NSCC/CoNtrOleR/README.md

# CoNtrOleR
The wiki contains our Scrum minutes

**our goal is to create a wooden chassis, usb  controller with the highest build quility we can manage**
