NSCC/CoNtrOleR/analog stick datasheet.png

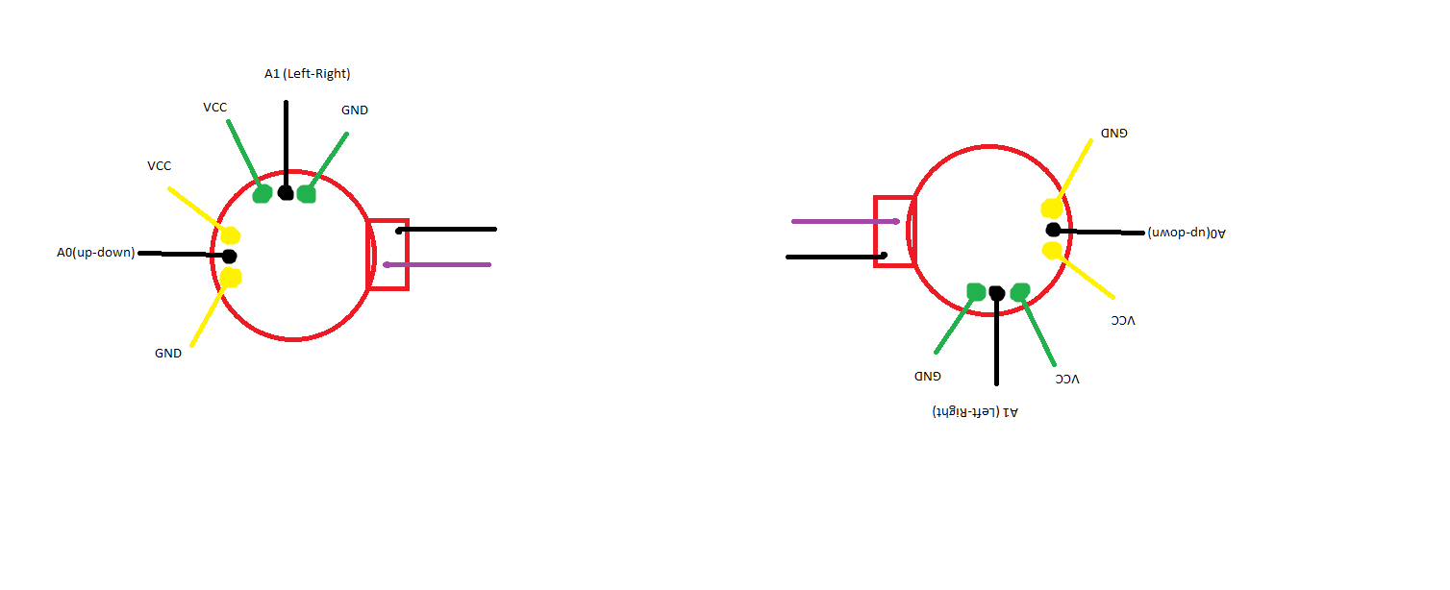
analog stick datasheet.png
