NSCC/CoNtrOleR/Project Management/PC-JP-NS-ProjectPlanning-Assignment3-Part2.xlsx

Sheet: Task_Table
ID | Active | Task Mode | Name | Duration | Start | Finish | Predecessors | Outline Level | Notes
1 | Yes | Manually Scheduled | Arduino I/O sketch | 0 hrs | March 4, 2019 8:00 AM | March 4, 2019 8:00 AM |  | 1
2 | Yes | Manually Scheduled | Bread-board prototype | 0 hrs | March 4, 2019 5:00 PM | March 4, 2019 5:00 PM |  | 1
3 | Yes | Manually Scheduled | Clay Model Chassis | 0 hrs | March 18, 2019 11:53 AM | March 18, 2019 11:53 AM |  | 1
4 | Yes | Manually Scheduled | Manufacturing Ready PCB | 0 hrs | March 25, 2019 5:00 PM | March 25, 2019 5:00 PM |  | 1
5 | Yes | Manually Scheduled | Complete 3D Chassis Model | 0 hrs | March 25, 2019 8:00 AM | March 25, 2019 8:00 AM |  | 1
6 | Yes | Manually Scheduled |  |  |  |  |  | 1
7 | Yes | Manually Scheduled | Calculated person hours: 272.2 |  |  |  |  | 1
8 | Yes | Manually Scheduled |  |  |  |  |  | 1
9 | Yes | Auto Scheduled | Program Physical Button Presses to Be Keyboard/Controller Output | 2 hrs | February 25, 2019 8:31 AM | February 25, 2019 10:31 AM |  | 1
10 | Yes | Auto Scheduled | Research Teensy Arduino API for button input/output | 1 hr | February 25, 2019 8:31 AM | February 25, 2019 9:31 AM |  | 2
11 | Yes | Auto Scheduled | Program Button Pinouts | 1 hr | February 25, 2019 9:31 AM | February 25, 2019 10:31 AM | 10 | 2
12 |  |  |  |  |  |  |  | 2
13 | Yes | Auto Scheduled | Program Physical Analog Stick Movement to Digital Analog Output | 2 hrs | February 25, 2019 10:35 AM | February 25, 2019 1:35 PM |  | 1
14 | Yes | Auto Scheduled | Research Analog Input and Output | 1 hr | February 25, 2019 10:35 AM | February 25, 2019 11:35 AM |  | 2
15 | Yes | Auto Scheduled | Program Analog Stick Pinouts | 1 hr | February 25, 2019 11:35 AM | February 25, 2019 1:35 PM | 14 | 2
16 |  |  |  |  |  |  |  | 2
17 | Yes | Auto Scheduled | Program A "Serial Mode" To Take Button Inputs As Serial Data | 6 hrs | February 26, 2019 9:11 AM | February 26, 2019 4:11 PM |  | 1
18 | Yes | Auto Scheduled | Research how to transmit data serially through a Teensy Arduino | 5 hrs | February 26, 2019 9:11 AM | February 26, 2019 3:11 PM |  | 2
19 | Yes | Auto Scheduled | Program Buttons To Transmit Only Serial Data For Software | 1 hr | February 26, 2019 3:11 PM | February 26, 2019 4:11 PM | 18 | 2
20 |  |  |  |  |  |  |  | 2
21 | Yes | Auto Scheduled | Program Software To Detect Arduino COM Port | 3 hrs | February 27, 2019 9:18 AM | February 27, 2019 1:18 PM |  | 1
22 | Yes | Auto Scheduled | Find A C99 Library That Can Detect COM Ports | 2 hrs | February 27, 2019 9:18 AM | February 27, 2019 11:18 AM |  | 2
23 | Yes | Auto Scheduled | Program COM Port Detection | 1 hr | February 27, 2019 11:18 AM | February 27, 2019 1:18 PM | 22 | 2
24 |  |  |  |  |  |  |  | 2
25 | Yes | Auto Scheduled | Read Serial Inputs And Give Variable Keyboard/Contoller Output | 8 hrs | February 27, 2019 1:18 PM | February 28, 2019 1:18 PM | 21 | 1
26 | Yes | Auto Scheduled | Take The Data From The COM Port And Parse It Into Manageable Data | 3 hrs | February 27, 2019 1:18 PM | February 27, 2019 4:18 PM |  | 2
27 | Yes | Auto Scheduled | Emulate Button Presses Based On Software Variables | 5 hrs | February 27, 2019 4:18 PM | February 28, 2019 1:18 PM | 26 | 2
28 |  |  |  |  |  |  |  | 2
29 | Yes | Auto Scheduled | GUI | 66.15 hrs | February 28, 2019 1:26 PM | March 12, 2019 3:35 PM |  | 1
30 | Yes | Auto Scheduled | Windows GUI | 29 hrs | February 28, 2019 1:26 PM | March 6, 2019 9:26 AM |  | 2
31 | Yes | Auto Scheduled | Program A Graphical Button-Mapping Software | 5 hrs | February 28, 2019 1:26 PM | March 1, 2019 9:26 AM |  | 3
32 | Yes | Auto Scheduled | Add Graphics | 8 hrs | March 1, 2019 9:26 AM | March 4, 2019 9:26 AM | 31 | 3
33 | Yes | Auto Scheduled | Add On-Click-Listeners | 8 hrs | March 4, 2019 9:26 AM | March 5, 2019 9:26 AM | 32 | 3
34 | Yes | Auto Scheduled | Program user controlled variables for button-mapping | 8 hrs | March 5, 2019 9:26 AM | March 6, 2019 9:26 AM | 33 | 3
35 | Yes | Auto Scheduled | LINUX GUI | 37 hrs | March 6, 2019 9:35 AM | March 12, 2019 3:35 PM |  | 2
36 | Yes | Auto Scheduled | Program a graphical button-mapping software | 13 hrs | March 6, 2019 9:35 AM | March 7, 2019 3:35 PM |  | 3
37 | Yes | Auto Scheduled | Add graphics | 8 hrs | March 7, 2019 3:35 PM | March 8, 2019 3:35 PM | 36 | 3
38 | Yes | Auto Scheduled | Add on-click listeners | 8 hrs | March 8, 2019 3:35 PM | March 11, 2019 3:35 PM | 37 | 3
39 | Yes | Auto Scheduled | Program user controlled variables for button-mapping | 8 hrs | March 11, 2019 3:35 PM | March 12, 2019 3:35 PM | 38 | 3
40 |  |  |  |  |  |  |  | 3
41 | Yes | Auto Scheduled | Bread-Board Circuit Design | 2 hrs | February 25, 2019 9:00 AM | February 25, 2019 11:00 AM |  | 1
42 | Yes | Auto Scheduled | Rough sketch of circuit | 1 hr | February 25, 2019 9:00 AM | February 25, 2019 10:00 AM |  | 2
43 | Yes | Auto Scheduled | Wire test circuit | 0.5 hrs | February 25, 2019 10:00 AM | February 25, 2019 10:30 AM | 42 | 2
44 | Yes | Auto Scheduled | Test the circuit | 0.5 hrs | February 25, 2019 10:30 AM | February 25, 2019 11:00 AM | 43 | 2
45 |  |  |  |  |  |  |  | 2
46 | Yes | Auto Scheduled | Perf-Board Circuit Design | 2.5 hrs | February 25, 2019 11:00 AM | February 25, 2019 2:30 PM |  | 1
47 | Yes | Auto Scheduled | Clean up rough sketch | 0.5 hrs | February 25, 2019 11:00 AM | February 25, 2019 11:30 AM |  | 2
48 | Yes | Auto Scheduled | Solder components to perf board | 1 hr | February 25, 2019 11:30 AM | February 25, 2019 1:30 PM | 47 | 2
49 | Yes | Auto Scheduled | Test the Circuit | 1 hr | February 25, 2019 1:30 PM | February 25, 2019 2:30 PM | 48 | 2
50 |  |  |  |  |  |  |  | 2
51 | Yes | Auto Scheduled | PCB Schematic | 5.2 hrs | February 25, 2019 2:30 PM | February 26, 2019 10:42 AM | 49 | 1
52 | Yes | Auto Scheduled | Create library components | 3 hrs | February 25, 2019 2:30 PM | February 26, 2019 8:30 AM |  | 2
53 | Yes | Auto Scheduled | Place components in schematic | 0.2 hrs | February 26, 2019 8:30 AM | February 26, 2019 8:42 AM | 52 | 2
54 | Yes | Auto Scheduled | Add PCB footprints | 1 hr | February 26, 2019 8:42 AM | February 26, 2019 9:42 AM | 53 | 2
55 | Yes | Auto Scheduled | Physical and electrical rules check | 1 hr | February 26, 2019 9:42 AM | February 26, 2019 10:42 AM | 54 | 2
56 |  |  |  |  |  |  |  | 2
57 | Yes | Auto Scheduled | PCB Footprints | 7.5 hrs | February 26, 2019 9:56 AM | February 27, 2019 9:26 AM |  | 1
58 | Yes | Auto Scheduled | Create throughhole pads | 3 hrs | February 26, 2019 9:56 AM | February 26, 2019 1:56 PM |  | 2
59 | Yes | Auto Scheduled | Draw the silkscreen outlines | 1 hr | February 26, 2019 1:56 PM | February 26, 2019 2:56 PM | 58 | 2
60 | Yes | Auto Scheduled | Place the throughhole pads | 0.5 hrs | February 26, 2019 2:56 PM | February 26, 2019 3:26 PM | 59 | 2
61 | Yes | Auto Scheduled | Add the Silkscreen text | 1 hr | February 26, 2019 3:26 PM | February 26, 2019 4:26 PM | 60 | 2
62 | Yes | Auto Scheduled | Add reference designators | 1 hr | February 26, 2019 4:26 PM | February 27, 2019 8:26 AM | 61 | 2
63 | Yes | Auto Scheduled | Add the frectangle | 1 hr | February 27, 2019 8:26 AM | February 27, 2019 9:26 AM | 62 | 2
64 |  |  |  |  |  |  |  | 2
65 | Yes | Auto Scheduled | PCB Design (rough) | 3 hrs | February 27, 2019 9:34 AM | February 27, 2019 1:34 PM |  | 1
66 | Yes | Auto Scheduled | Place all the components from the schematic | 1 hr | February 27, 2019 9:34 AM | February 27, 2019 10:34 AM |  | 2
67 | Yes | Auto Scheduled | Arrange components around the estimated button positions | 1 hr | February 27, 2019 10:34 AM | February 27, 2019 11:34 AM | 66 | 2
68 | Yes | Auto Scheduled | Route traces | 1 hr | February 27, 2019 11:34 AM | February 27, 2019 1:34 PM | 67 | 2
69 |  |  |  |  |  |  |  | 2
70 | Yes | Auto Scheduled | PCB Design (finished) | 4 hrs | February 27, 2019 1:34 PM | February 28, 2019 8:34 AM | 65 | 1
71 | Yes | Auto Scheduled | Get the exact measurements from the 3d model | 1 hr | February 27, 2019 1:34 PM | February 27, 2019 2:34 PM |  | 2
72 | Yes | Auto Scheduled | Adjust components | 2 hrs | February 27, 2019 2:34 PM | February 27, 2019 4:34 PM | 71 | 2
73 | Yes | Auto Scheduled | Re-route traces | 1 hr | February 27, 2019 4:34 PM | February 28, 2019 8:34 AM | 72 | 2
74 | Yes | Auto Scheduled | Manufacturing | 22 hrs? | February 28, 2019 8:34 AM | March 4, 2019 3:34 PM | 70 | 1
75 | Yes | Auto Scheduled | Find a manufacturer | 8 hrs | February 28, 2019 8:34 AM | March 1, 2019 8:34 AM |  | 2
76 | Yes | Auto Scheduled | Prepare the PCB for manufacturing based on their specifications | 1 hr | March 1, 2019 8:34 AM | March 1, 2019 9:34 AM | 75 | 2
77 | Yes | Auto Scheduled | Create a gerbV file to send to the manufactuer | 13 hrs? | March 1, 2019 9:34 AM | March 4, 2019 3:34 PM | 76 | 2
78 |  |  |  |  |  |  |  | 2
79 |  |  |  |  |  |  |  | 2
80 | Yes | Auto Scheduled | Solder/wire the components | 4 hrs | March 4, 2019 3:34 PM | March 5, 2019 10:34 AM | 74 | 1
81 | Yes | Auto Scheduled | Solder the Teensy Arduino to the PCB | 1 hr | March 4, 2019 3:34 PM | March 4, 2019 4:34 PM |  | 2
82 | Yes | Auto Scheduled | Solder headers for buttons | 1 hr | March 4, 2019 4:34 PM | March 5, 2019 8:34 AM | 81 | 2
83 | Yes | Auto Scheduled | Solder analog sticks | 1 hr | March 5, 2019 8:34 AM | March 5, 2019 9:34 AM | 82 | 2
84 | Yes | Auto Scheduled | Solder the rumble motor | 1 hr | March 5, 2019 9:34 AM | March 5, 2019 10:34 AM | 83 | 2
85 |  |  |  |  |  |  |  | 2
86 | Yes | Auto Scheduled | Basic 2D Button Layout | 3 hrs | February 25, 2019 9:00 AM | February 25, 2019 12:00 PM |  | 1
87 | Yes | Auto Scheduled | Buy various mechanical key switches | 1 hr | February 25, 2019 9:00 AM | February 25, 2019 10:00 AM |  | 2
88 | Yes | Auto Scheduled | Pick keyswitches | 1 hr | February 25, 2019 10:00 AM | February 25, 2019 11:00 AM | 87 | 2
89 | Yes | Auto Scheduled | Plan out layout and spacing | 1 hr | February 25, 2019 11:00 AM | February 25, 2019 12:00 PM | 88 | 2
90 |  |  |  |  |  |  |  | 2
91 | Yes | Auto Scheduled | Clay Model | 19 hrs | February 25, 2019 1:00 PM | February 27, 2019 4:00 PM | 86 | 1
92 | Yes | Auto Scheduled | Model the clay in the shape of a controller | 13 hrs | February 25, 2019 1:00 PM | February 27, 2019 9:00 AM |  | 2
93 | Yes | Auto Scheduled | Get feed back on the controller design | 1 hr | February 27, 2019 9:00 AM | February 27, 2019 10:00 AM | 92 | 2
94 | Yes | Auto Scheduled | adjust the model based on the feed back | 5 hrs | February 27, 2019 10:00 AM | February 27, 2019 4:00 PM | 93 | 2
95 |  |  |  |  |  |  |  | 2
96 | Yes | Auto Scheduled | Virtualize The Model | 33 hrs | February 27, 2019 4:00 PM | March 5, 2019 5:00 PM | 91 | 1
97 | Yes | Auto Scheduled | Take pictures of the clay model | 1 hr | February 27, 2019 4:00 PM | February 27, 2019 5:00 PM |  | 2
98 | Yes | Auto Scheduled | Use the pictures in Fusion360 to create canvases | 1 hr | February 28, 2019 9:00 AM | February 28, 2019 10:00 AM | 97 | 2
99 | Yes | Auto Scheduled | Use canvas to extrude 3D model | 2 hrs | February 28, 2019 10:00 AM | February 28, 2019 12:00 PM | 98 | 2
100 | Yes | Auto Scheduled | Shape the bridge | 13 hrs | February 28, 2019 1:00 PM | March 4, 2019 9:00 AM | 99 | 2
101 | Yes | Auto Scheduled | Shape grips | 13 hrs | March 4, 2019 9:00 AM | March 5, 2019 3:00 PM | 100 | 2
102 | Yes | Auto Scheduled | Finishing touches | 2 hrs | March 5, 2019 3:00 PM | March 5, 2019 5:00 PM | 101 | 2
103 |  |  |  |  |  |  |  | 2
104 | Yes | Auto Scheduled | Carve Model | 15 hrs | March 6, 2019 9:00 AM | March 7, 2019 5:00 PM | 96 | 1
105 | Yes | Auto Scheduled | Section 3d model into 4 parts | 3 hrs | March 6, 2019 9:00 AM | March 6, 2019 12:00 PM |  | 2
106 | Yes | Auto Scheduled | Carve the top layer outside | 3 hrs | March 6, 2019 1:00 PM | March 6, 2019 4:00 PM | 105 | 2
107 | Yes | Auto Scheduled | Carve the top layer inside | 3 hrs | March 6, 2019 4:00 PM | March 7, 2019 10:00 AM | 106 | 2
108 | Yes | Auto Scheduled | Carve bottom layer outside | 3 hrs | March 7, 2019 10:00 AM | March 7, 2019 2:00 PM | 107 | 2
109 | Yes | Auto Scheduled | Carve bottom layer inside | 3 hrs | March 7, 2019 2:00 PM | March 7, 2019 5:00 PM | 108 | 2
110 |  |  |  |  |  |  |  | 2
111 | Yes | Auto Scheduled | Finishing the Wood | 4.5 hrs | March 8, 2019 9:00 AM | March 8, 2019 2:30 PM | 104 | 1
112 | Yes | Auto Scheduled | Sand the entire model with 500 grit | 1 hr | March 8, 2019 9:00 AM | March 8, 2019 10:00 AM |  | 2
113 | Yes | Auto Scheduled | Sand the model with 1000 grit | 1 hr | March 8, 2019 10:00 AM | March 8, 2019 11:00 AM | 112 | 2
114 | Yes | Auto Scheduled | Sand the model with 5000 grit | 1 hr | March 8, 2019 11:00 AM | March 8, 2019 12:00 PM | 113 | 2
115 | Yes | Auto Scheduled | Test the fit of the model pieces | 1 hr | March 8, 2019 1:00 PM | March 8, 2019 2:00 PM | 114 | 2
116 | Yes | Auto Scheduled | Polish the model pieces | 0.5 hrs | March 8, 2019 2:00 PM | March 8, 2019 2:30 PM | 115 | 2
117 |  |  |  |  |  |  |  | 2
118 | Yes | Auto Scheduled | Rumble Support | 5 hrs | March 4, 2019 3:34 PM | March 5, 2019 11:34 AM | 74 | 1
119 | Yes | Auto Scheduled | Research Rumble Input From a PC To a Teensy Arduino | 3 hrs | March 4, 2019 3:34 PM | March 5, 2019 9:34 AM |  | 2
120 | Yes | Auto Scheduled | Modify the PCB to Accommodate Rumble Pins | 1 hr | March 5, 2019 9:34 AM | March 5, 2019 10:34 AM | 119 | 2
121 | Yes | Auto Scheduled | Modify the 3D Model to Accommodate the Rumble Motors | 1 hr | March 5, 2019 10:34 AM | March 5, 2019 11:34 AM | 120 | 2
122 |  |  |  |  |  |  |  | 2
123 | Yes | Auto Scheduled | Assemble Controller | 16 hrs | March 11, 2019 9:00 AM | March 13, 2019 9:00 AM | 80,111 | 1
124 | Yes | Auto Scheduled | Put the soldered PCB into the chassis | 8 hrs | March 11, 2019 9:00 AM | March 12, 2019 9:00 AM |  | 2
125 | Yes | Auto Scheduled | Connect the top and bottom of chassis and secure | 8 hrs | March 12, 2019 9:00 AM | March 13, 2019 9:00 AM | 124 | 2
126 |  |  |  |  |  |  |  | 2
127 | Yes | Auto Scheduled | Quality Control (Last minute troubleshooting) | 60 hrs | March 5, 2019 11:00 AM | March 14, 2019 4:00 PM |  | 1
128 | Yes | Auto Scheduled | Durability Test | 0.5 hrs | March 13, 2019 9:00 AM | March 13, 2019 9:30 AM | 123 | 2
129 | Yes | Auto Scheduled | Button/Stick Check | 0.5 hrs | March 5, 2019 11:00 AM | March 5, 2019 11:30 AM | 80 | 2
130 | Yes | Auto Scheduled | Connectivity Check | 0.5 hrs | March 5, 2019 1:00 PM | March 5, 2019 1:30 PM | 25,80 | 2
131 | Yes | Auto Scheduled | Button/Analog Input Check | 1 hr | March 13, 2019 3:00 PM | March 13, 2019 4:00 PM | 25,80 | 2
132 | Yes | Auto Scheduled | Software Check | 0.5 hrs | March 12, 2019 3:35 PM | March 12, 2019 4:05 PM | 29 | 2
133 | Yes | Auto Scheduled | Button Mapping Check | 0.5 hrs | March 12, 2019 3:35 PM | March 12, 2019 4:05 PM | 29 | 2
134 | Yes | Auto Scheduled | Fix Problems | 8 hrs | March 13, 2019 4:00 PM | March 14, 2019 4:00 PM | 131 | 2

Sheet: Resource_Table
ID | Name | Initials | Type | Material Label | Group | Email Address | User Logon Account | Max Units | Standard Rate | Cost Per Use | Notes
1 | Arduino Teensy | A | Work |  |  |  |  | 100% | $0.00/h | 0
2 | Polymer Clay | P | Work |  |  |  |  | 100% | $0.00/h | 0
3 | Analog Sticks | A | Work |  |  |  |  | 100% | $0.00/h | 0
4 | Mechanical Keyswitches | M | Work |  |  |  |  | 100% | $0.00/h | 0
5 | Sculpting Tools | S | Work |  |  |  |  | 100% | $0.00/h | 0
6 | 18 AWG Wire | 1 | Work |  |  |  |  | 100% | $0.00/h | 0
7 | Soldering Station | S | Work |  |  |  |  | 100% | $0.00/h | 0
8 | Wood | W | Work |  |  |  |  | 100% | $0.00/h | 0
9 | CNC Machine | C | Work |  |  |  |  | 100% | $0.00/h | 0
10 | Wood Polish | W | Work |  |  |  |  | 100% | $0.00/h | 0
11 | Rumble Motors | R | Work |  |  |  |  | 100% | $0.00/h | 0
12 | Resistors | R | Work |  |  |  |  | 100% | $0.00/h | 0
13 | USB Cable | U | Work |  |  |  |  | 100% | $0.00/h | 0
14 | Perf board | P | Work |  |  |  |  | 100% | $0.00/h | 0
15 | PCB | P | Work |  |  |  |  | 100% | $0.00/h | 0
16 | Keycaps | K | Work |  |  |  |  | 100% | $0.00/h | 0
17 | Power Tools | P | Work |  |  |  |  | 100% | $0.00/h | 0
18 | Sandpaper | S | Work |  |  |  |  | 100% | $0.00/h | 0
19 | Lacquer Wood Finish | L | Work |  |  |  |  | 100% | $0.00/h | 0
20 | Debouncer | D | Work |  |  |  |  | 100% | $0.00/h | 0
21 | Glue | G | Work |  |  |  |  | 100% | $0.00/h | 0
22 | Screws | S | Work |  |  |  |  | 100% | $0.00/h | 0
23 | Bread Board | B | Work |  |  |  |  | 100% | $0.00/h | 0
24 | Headers | H | Work |  |  |  |  | 100% | $0.00/h | 0
25 | Diode | D | Work |  |  |  |  | 100% | $0.00/h | 0
26 | Camera | C | Work |  |  |  |  | 100% | $0.00/h | 0

Sheet: Assignment_Table
Task Name | Resource Name | % Work Complete | Work | Units
Program Analog Stick Pinouts | Analog Sticks | 0 | 1h | 100%
Program Software To Detect Arduino COM Port | Arduino Teensy | 0 | 3h | 100%
Program COM Port Detection | Arduino Teensy | 0 | 1h | 100%
Wire test circuit | 18 AWG Wire | 0 | 0.5h | 100%
Wire test circuit | Analog Sticks | 0 | 0.5h | 100%
Wire test circuit | Bread Board | 0 | 0.5h | 100%
Wire test circuit | Keycaps | 0 | 0.5h | 100%
Wire test circuit | Mechanical Keyswitches | 0 | 0.5h | 100%
Wire test circuit | Resistors | 0 | 0.5h | 100%
Solder components to perf board | 18 AWG Wire | 0 | 1h | 100%
Solder components to perf board | Analog Sticks | 0 | 1h | 100%
Solder components to perf board | Bread Board | 0 | 1h | 100%
Solder components to perf board | Keycaps | 0 | 1h | 100%
Solder components to perf board | Mechanical Keyswitches | 0 | 1h | 100%
Solder components to perf board | Perf board | 0 | 1h | 100%
Solder components to perf board | Resistors | 0 | 1h | 100%
Solder components to perf board | Soldering Station | 0 | 1h | 100%
Solder components to perf board | USB Cable | 0 | 1h | 100%
Solder the Teensy Arduino to the PCB | Arduino Teensy | 0 | 1h | 100%
Solder the Teensy Arduino to the PCB | PCB | 0 | 1h | 100%
Solder the Teensy Arduino to the PCB | Soldering Station | 0 | 1h | 100%
Solder headers for buttons | Arduino Teensy | 0 | 1h | 100%
Solder headers for buttons | PCB | 0 | 1h | 100%
Solder headers for buttons | Headers | 0 | 1h | 100%
Solder headers for buttons | Soldering Station | 0 | 1h | 100%
Solder analog sticks | Analog Sticks | 0 | 1h | 100%
Solder analog sticks | Arduino Teensy | 0 | 1h | 100%
Solder analog sticks | PCB | 0 | 1h | 100%
Solder analog sticks | Soldering Station | 0 | 1h | 100%
Solder the rumble motor | Arduino Teensy | 0 | 1h | 100%
Solder the rumble motor | PCB | 0 | 1h | 100%
Solder the rumble motor | Rumble Motors | 0 | 1h | 100%
Solder the rumble motor | Soldering Station | 0 | 1h | 100%
Solder the rumble motor | Resistors | 0 | 1h | 100%
Solder the rumble motor | Diode | 0 | 1h | 100%
Buy various mechanical key switches | Keycaps | 0 | 1h | 100%
Buy various mechanical key switches | Mechanical Keyswitches | 0 | 1h | 100%
Pick keyswitches | Keycaps | 0 | 1h | 100%
Pick keyswitches | Mechanical Keyswitches | 0 | 1h | 100%
Plan out layout and spacing | Keycaps | 0 | 1h | 100%
Plan out layout and spacing | Mechanical Keyswitches | 0 | 1h | 100%
Model the clay in the shape of a controller | Polymer Clay | 0 | 13h | 100%
Model the clay in the shape of a controller | Sculpting Tools | 0 | 13h | 100%
Get feed back on the controller design | Polymer Clay | 0 | 1h | 100%
Get feed back on the controller design | Sculpting Tools | 0 | 1h | 100%
adjust the model based on the feed back | Polymer Clay | 0 | 5h | 100%
adjust the model based on the feed back | Sculpting Tools | 0 | 5h | 100%
Take pictures of the clay model | Camera | 0 | 1h | 100%
Take pictures of the clay model | Polymer Clay | 0 | 1h | 100%
Carve the top layer outside | CNC Machine | 0 | 3h | 100%
Carve the top layer outside | Wood | 0 | 3h | 100%
Carve the top layer inside | CNC Machine | 0 | 3h | 100%
Carve the top layer inside | Wood | 0 | 3h | 100%
Carve bottom layer outside | CNC Machine | 0 | 3h | 100%
Carve bottom layer outside | Wood | 0 | 3h | 100%
Carve bottom layer inside | CNC Machine | 0 | 3h | 100%
Carve bottom layer inside | Wood | 0 | 3h | 100%
Sand the entire model with 500 grit | Sandpaper | 0 | 1h | 100%
Sand the model with 1000 grit | Sandpaper | 0 | 1h | 100%
Sand the model with 5000 grit | Sandpaper | 0 | 1h | 100%
Polish the model pieces | Wood Polish | 0 | 0.5h | 100%
Polish the model pieces | Lacquer Wood Finish | 0 | 0.5h | 100%
Research Rumble Input From a PC To a Teensy Arduino | Arduino Teensy | 0 | 3h | 100%
Put the soldered PCB into the chassis | PCB | 0 | 8h | 100%
Connect the top and bottom of chassis and secure | Glue | 0 | 8h | 100%
Connect the top and bottom of chassis and secure | Power Tools | 0 | 8h | 100%
Connect the top and bottom of chassis and secure | Screws | 0 | 8h | 100%
