NSCC/CoNtrOleR/CADD model/body.stl

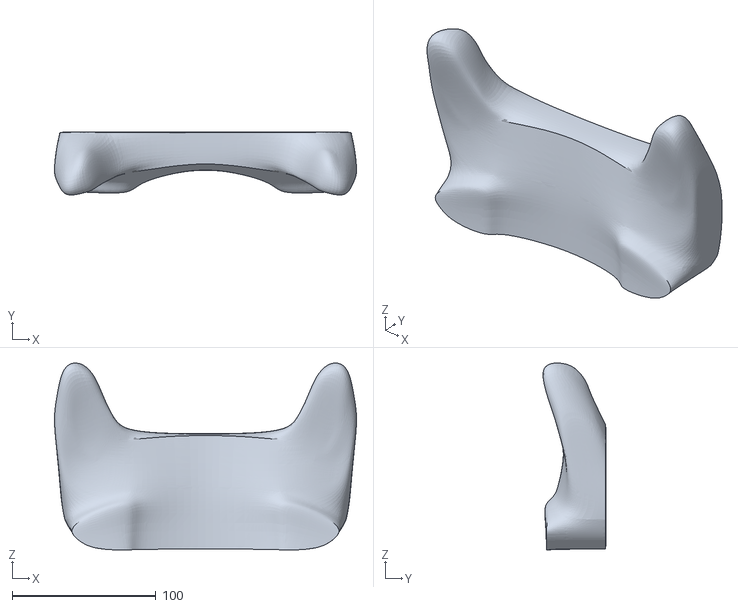
[picture p3: CAD file, 2019-04-12]
CADD model/body.stl
210.1 x 43.8 x 130.0
