NSCC/CoNtrOleR/CADD model/cover_1mm_top.stl

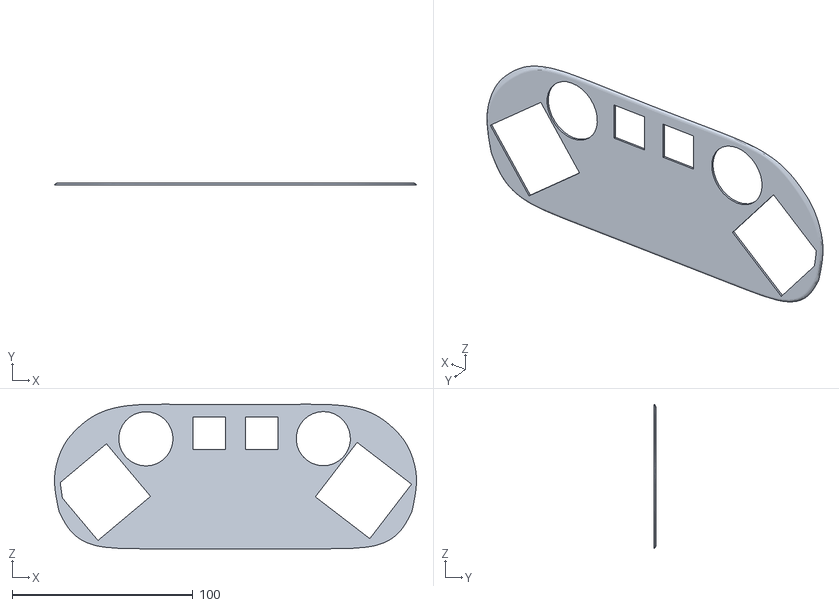
[picture p4: CAD file, 2019-04-12]
CADD model/cover_1mm_top.stl
200.4 x 1.00 x 80.0
