NSCC/CoNtrOleR/CADD model/cover_mid.stl

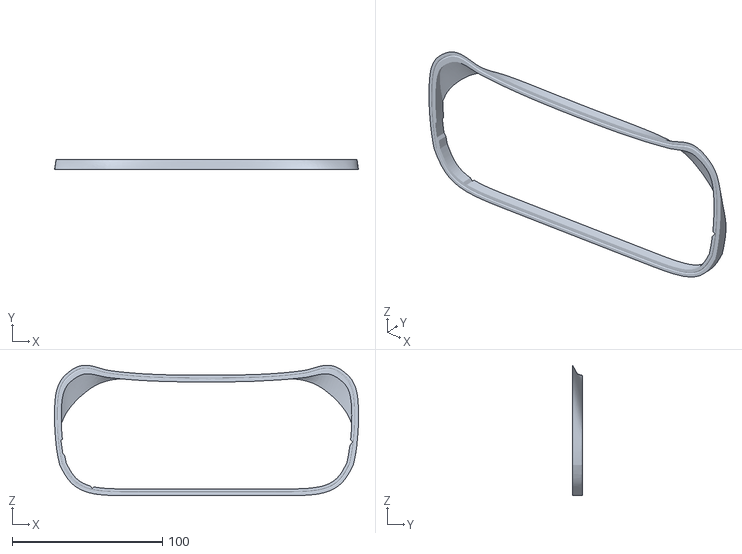
[picture p5: CAD file, 2019-04-12]
CADD model/cover_mid.stl
202.6 x 6.36 x 87.0
